MAWoodMain/PowerMonitorMK4/Hat/PDF Schematic/Hat.pdf

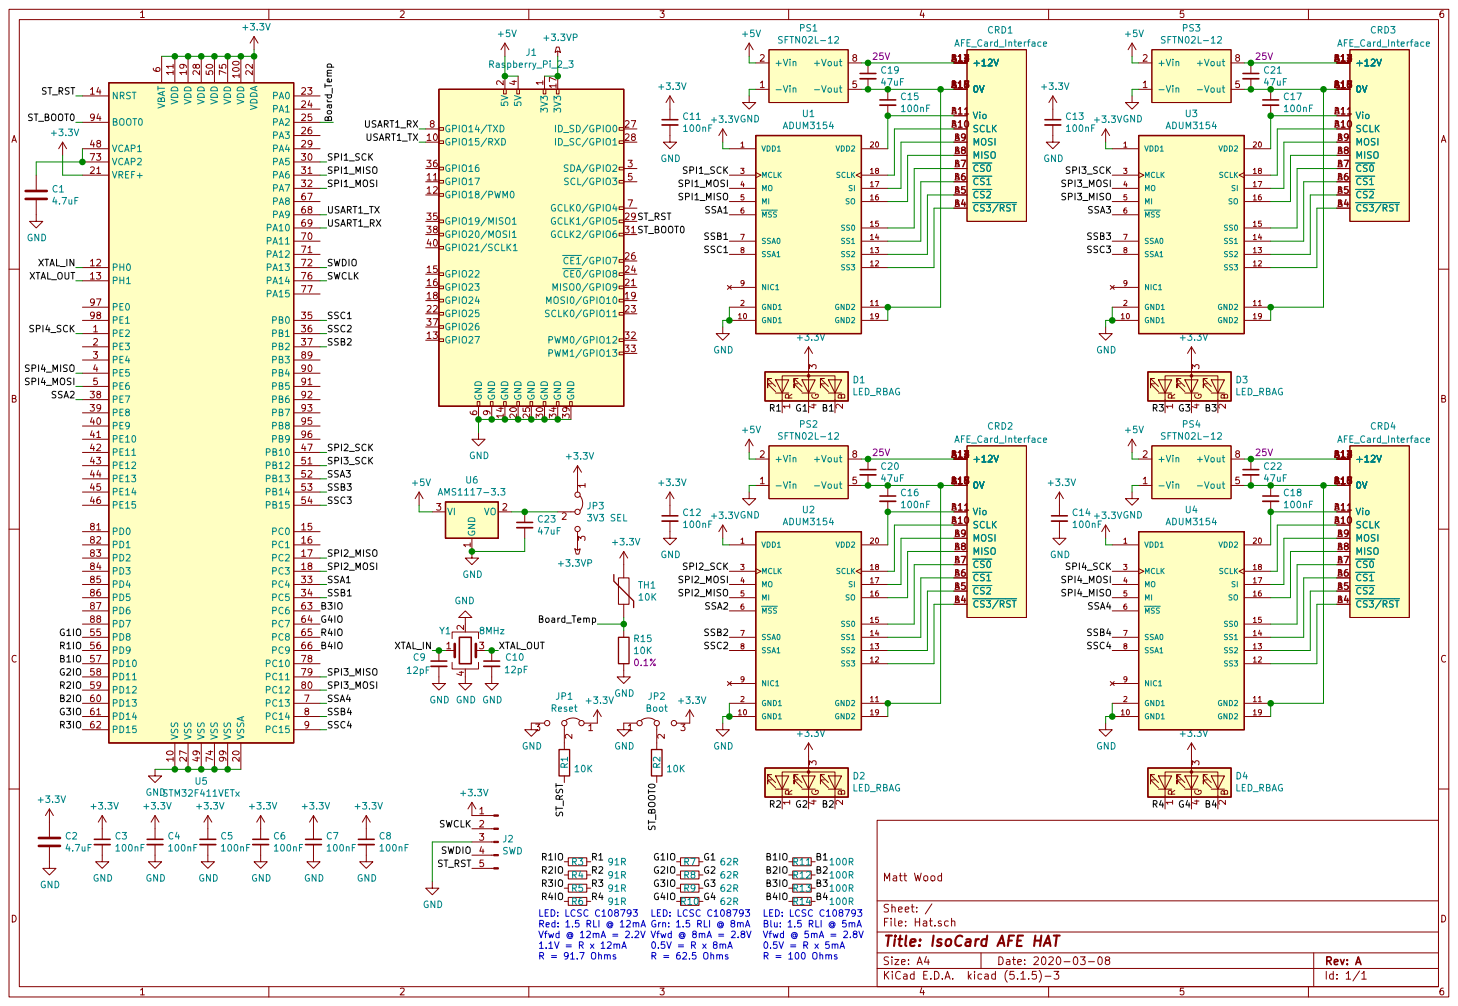
[picture p1: page 1]

6 VCAP1 48 VCAP2 73 VDD 100 VDD 11 VDD 19 VDD 28 VDD 50 VDD 75 VDDA 22 VREF+ 21 VSS 10 VSS 27 VSS 49 VSS 74 VSS 99 VSSA 20 U5 STM32F411VETx

File: Hat.sch Sheet: / Matt Wood

0.5V = R x 8mA R = 62.5 Ohms LED: LCSC C108793 Red: 1.5 RLI @ 12mA

Id: 1/1 Title: IsoCard AFE HAT
