MAWoodMain/PowerMonitorMK4/VC-01 Card/PDF Schematic/VC-01 Card.pdf

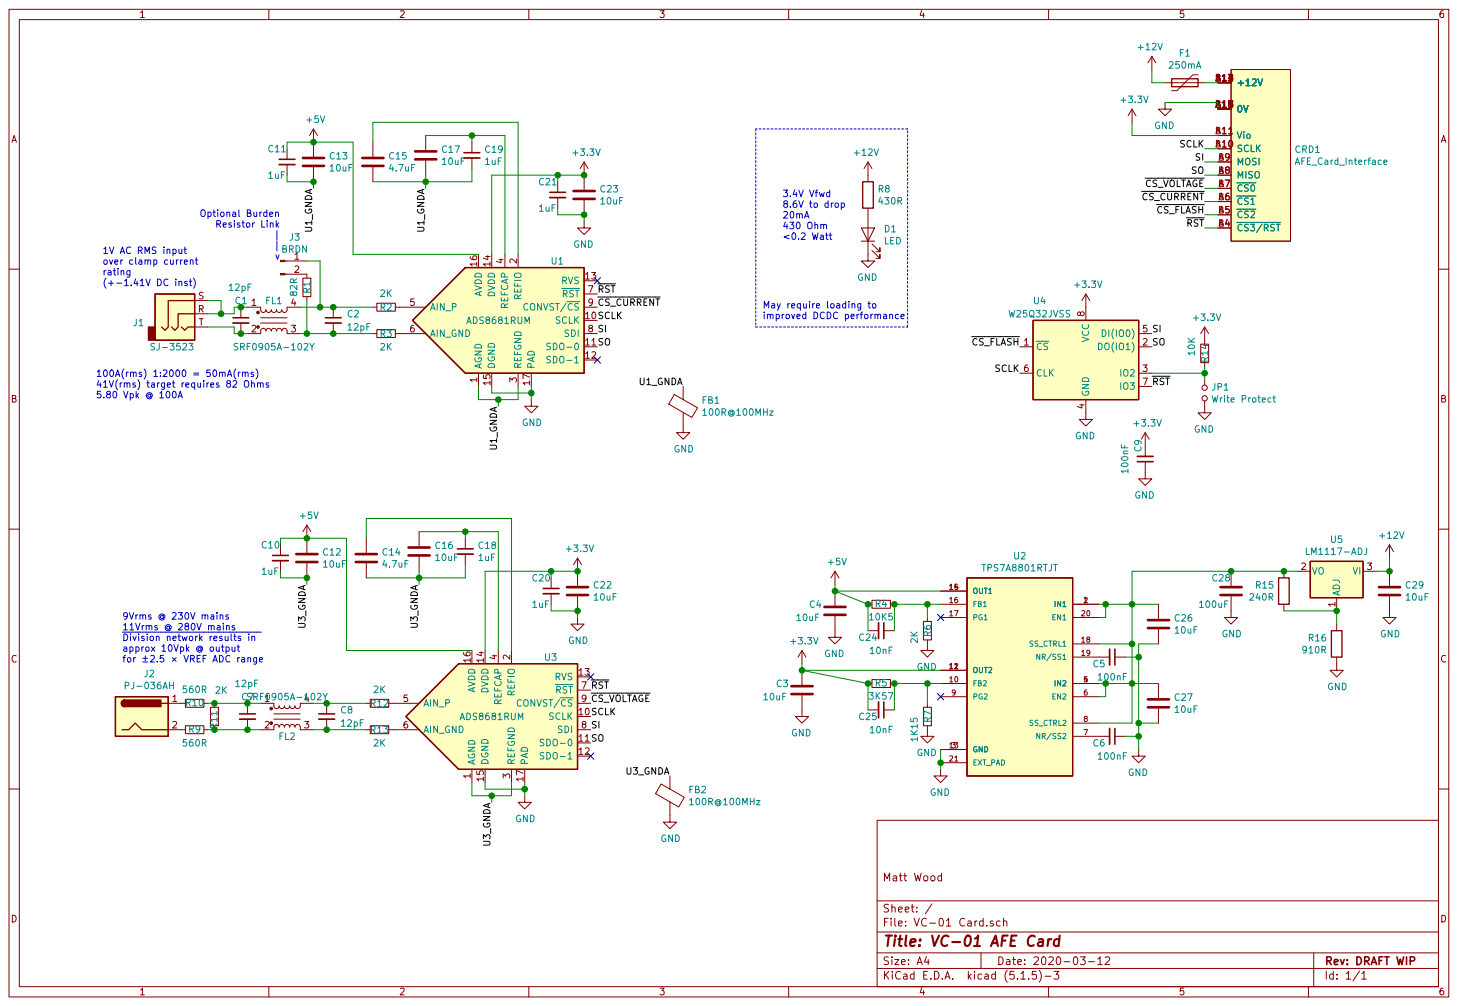
[picture p2: page 1]

Optional Burden Resistor Link

4 AIN_P 5 AIN_GND 6 RST 7 SDI 8 CONVST/CS 9 U1 ADS8681RUM

1 SCLK 10 SDO-0 11 SDO-1 12 RVS 13 DVDD 14 DGND 15 AVDD 16 PAD 17 REFIO

100A(rms) 1:2000 = 50mA(rms)
41V(rms) target requires 82 Ohms
5.80 Vpk @ 100A

9Vrms @ 230V mains 11Vrms @ 280V mains Division network results in approx 10Vpk @ output

4 AIN_P 5 AIN_GND 6 RST 7 SDI 8 CONVST/CS 9 U3 ADS8681RUM

for ±2.5 × VREF ADC range

File: VC-01 Card.sch Sheet: / Matt Wood

Id: 1/1 Title: VC-01 AFE Card
