MAWoodMain/PowerMonitorMK4/Hat/PDF Gerbers/Hat-B_Paste.pdf

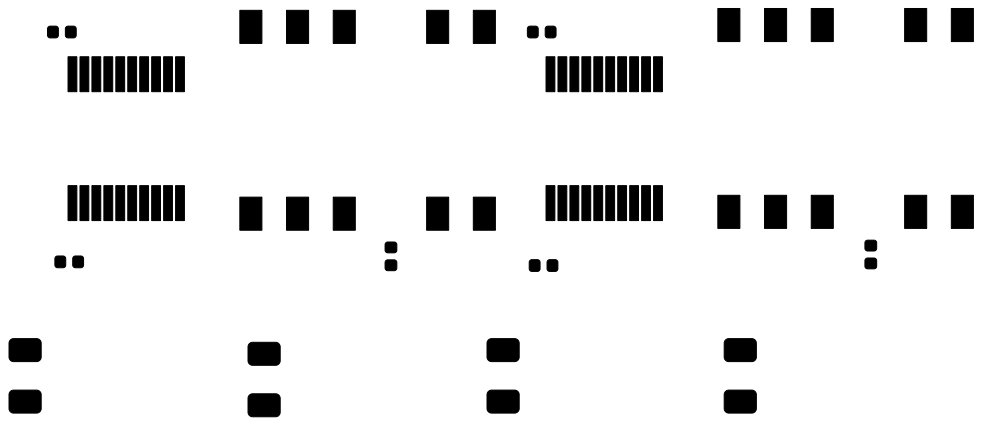
[picture p5: page 1]

File: Hat.kicad_pcb Sheet: Matt Wood

Id: 1/1 Title: IsoCard AFE HAT
