MAWoodMain/PowerMonitorMK4/Hat/PDF Gerbers/Hat-B_SilkS.pdf

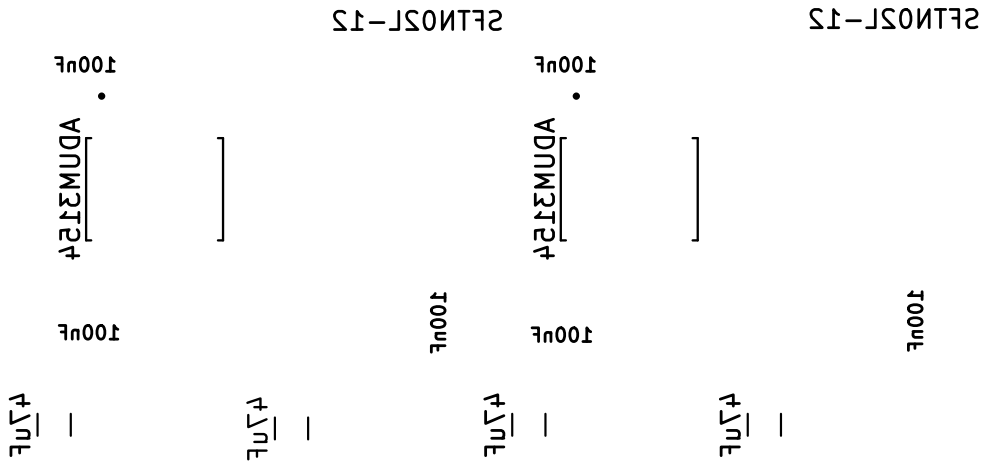
[picture p6: page 1]

File: Hat.kicad_pcb Sheet: Matt Wood

Id: 1/1 Title: IsoCard AFE HAT
