MAWoodMain/PowerMonitorMK4/Hat/PDF Gerbers/Hat-Edge_Cuts.pdf

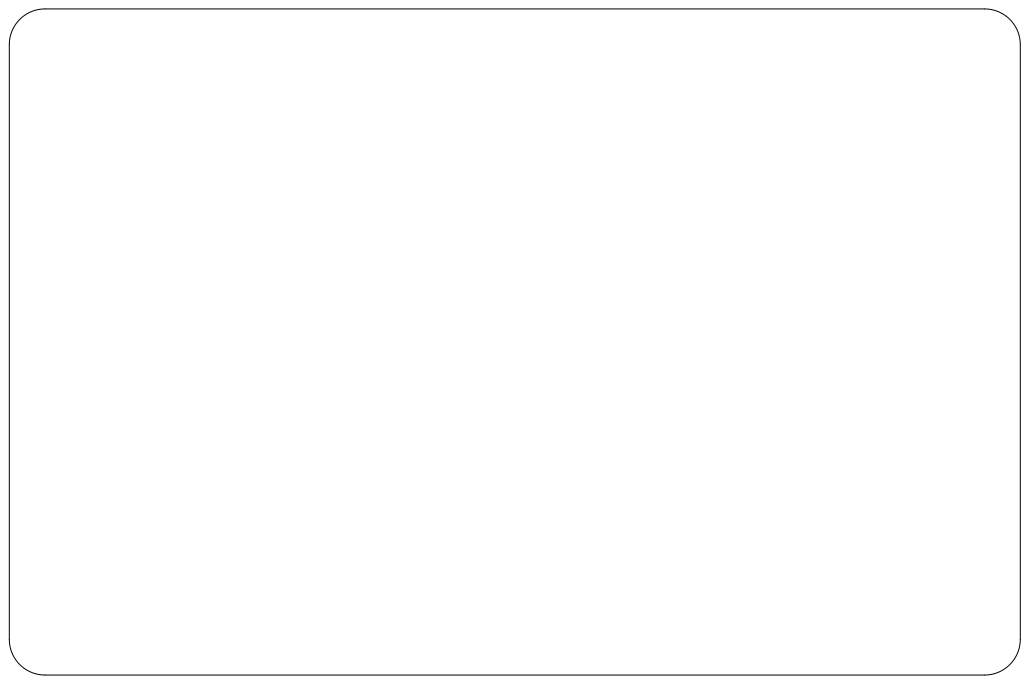
[picture p7: page 1]

File: Hat.kicad_pcb Sheet: Matt Wood

Id: 1/1 Title: IsoCard AFE HAT
