MAWoodMain/PowerMonitorMK4/Hat/PDF Gerbers/Hat-F_Cu.pdf

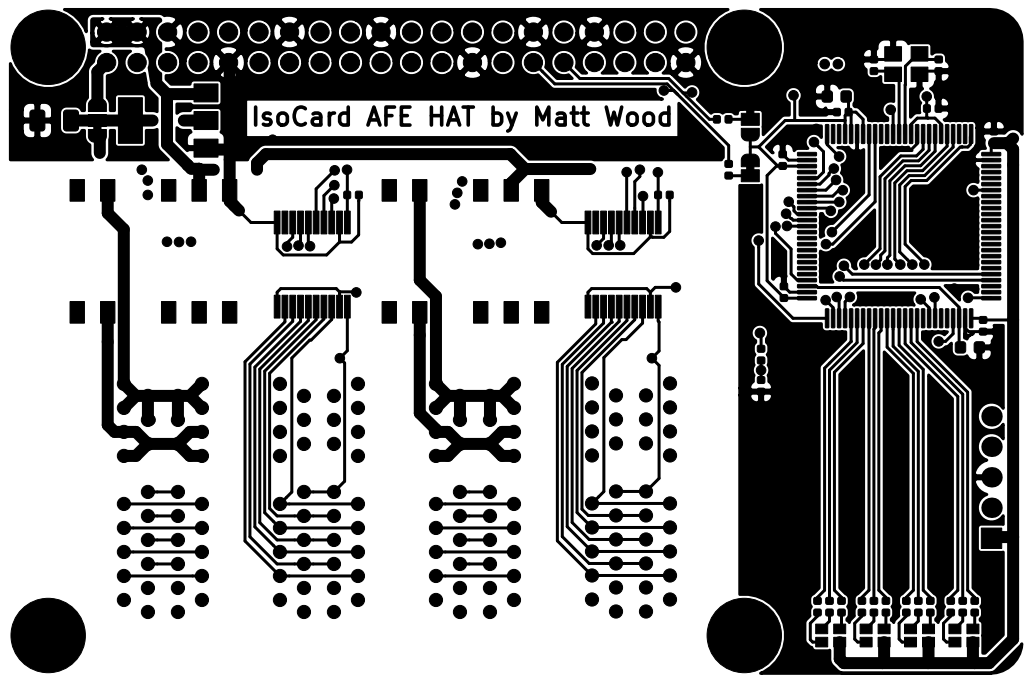
[picture p8: page 1]

IsoCard AFE HAT by Matt Wood

File: Hat.kicad_pcb Sheet: Matt Wood

Id: 1/1 Title: IsoCard AFE HAT
