MAWoodMain/PowerMonitorMK4/Hat/PDF Gerbers/Hat-F_Paste.pdf

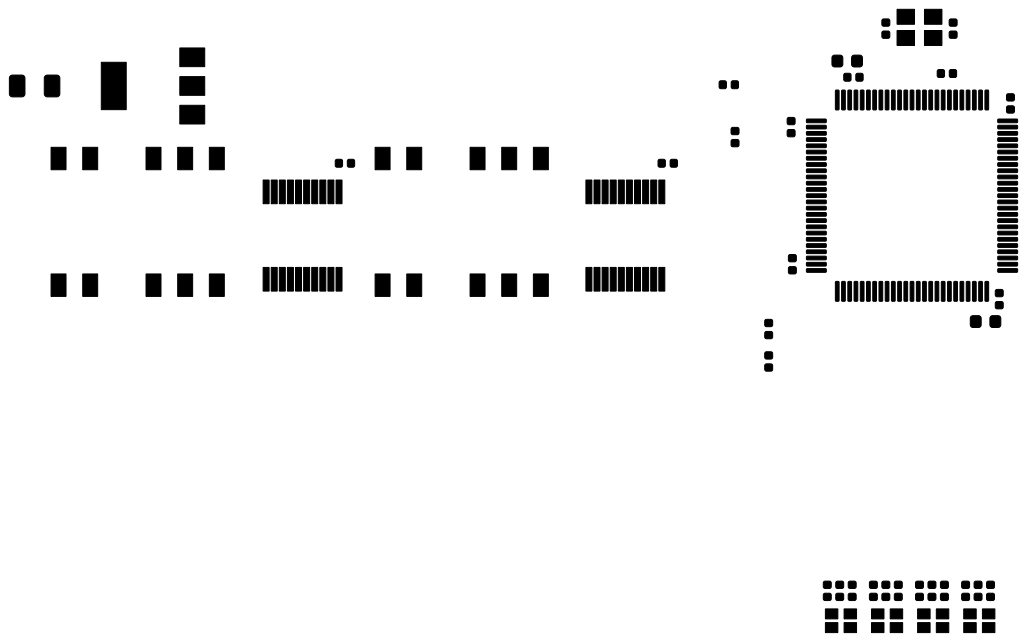
[picture p9: page 1]

File: Hat.kicad_pcb Sheet: Matt Wood

Id: 1/1 Title: IsoCard AFE HAT
