MAWoodMain/PowerMonitorMK4/Hat/PDF Gerbers/Hat-F_SilkS.pdf

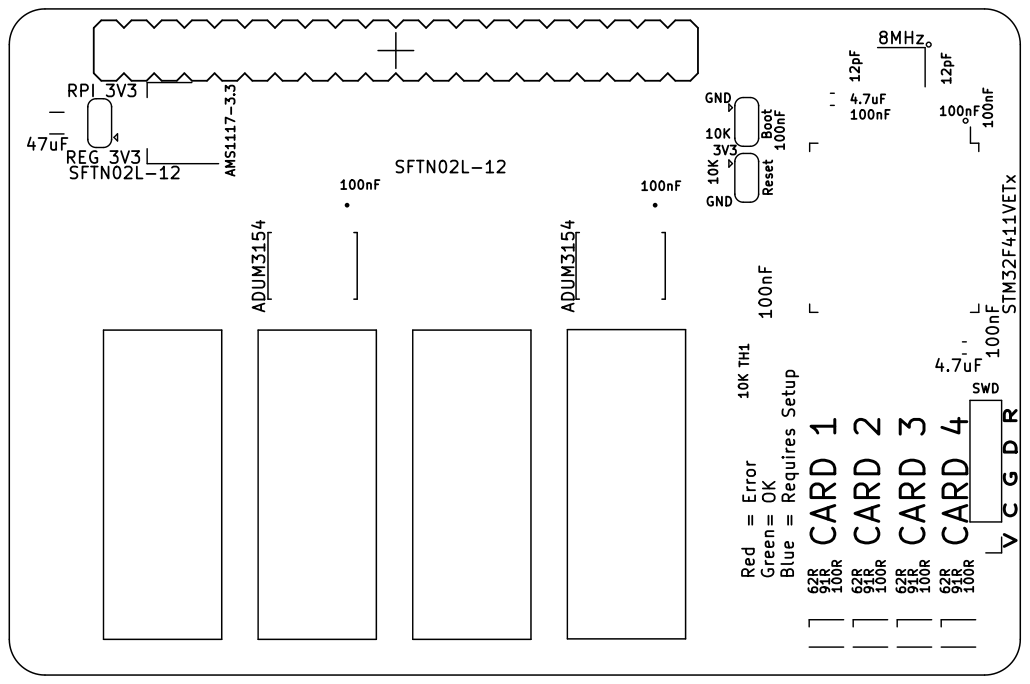
[picture p10: page 1]

3V3 Red Green BlueCARD 1 CARD 2 CARD 3 CARD 4

File: Hat.kicad_pcb Sheet: Matt Wood

Id: 1/1 Title: IsoCard AFE HAT
