MAWoodMain/PowerMonitorMK4/Hat/PDF Gerbers/Hat-In1_Cu.pdf

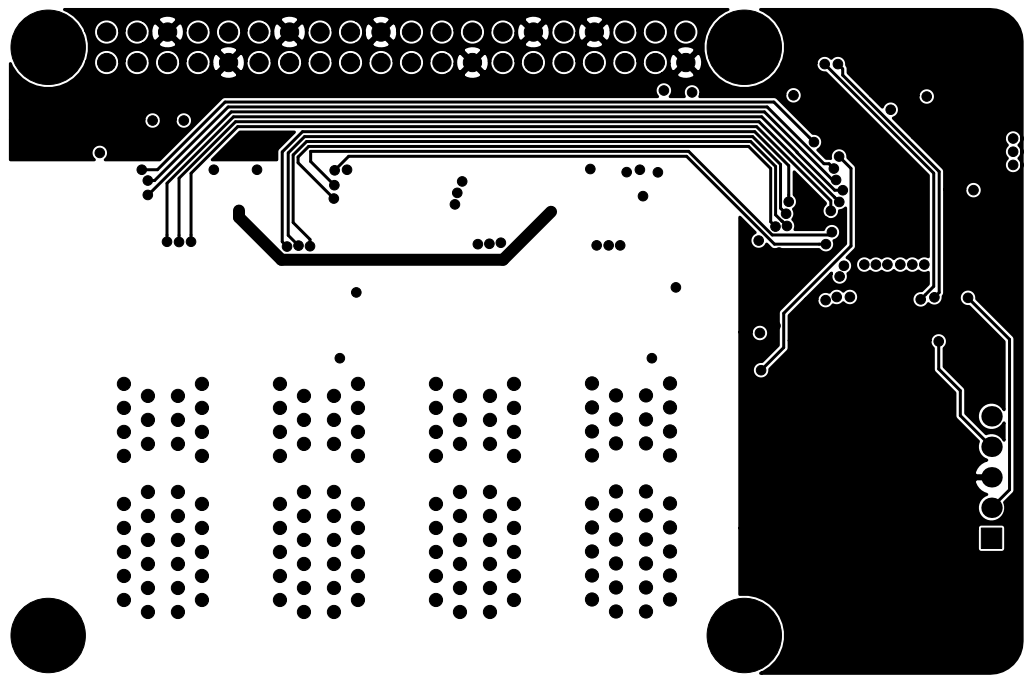
[picture p11: page 1]

File: Hat.kicad_pcb Sheet: Matt Wood

Id: 1/1 Title: IsoCard AFE HAT
