MAWoodMain/PowerMonitorMK4/VC-01 Card/PDF Gerbers/VC-01 Card-B_Mask.pdf

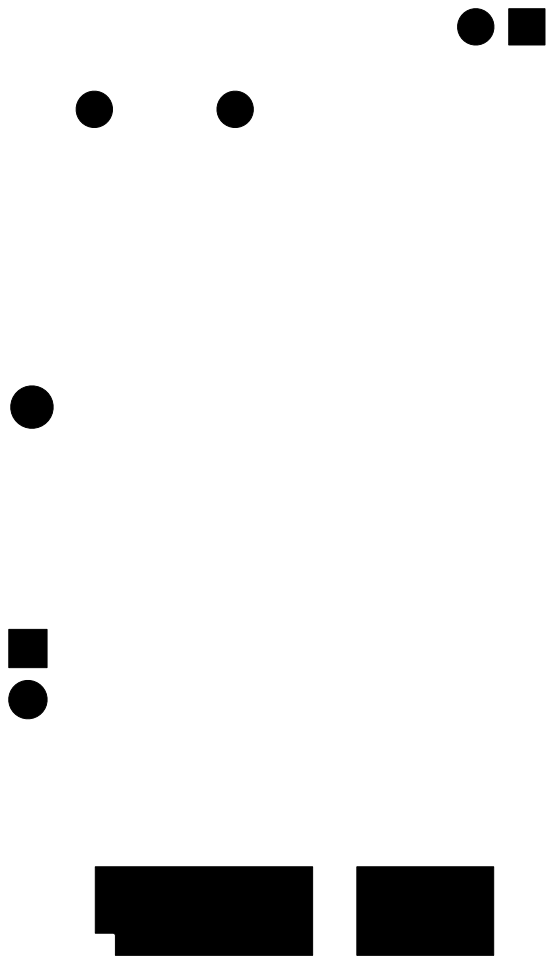
[picture p14: page 1]

File: VC-01 Card.kicad_pcb Sheet: Matt Wood

Id: 1/1 Title: VC-01 AFE Card
