MAWoodMain/PowerMonitorMK4/Hat/Hat.kicad_pcb

## KiCad design Hat/Hat.kicad_pcb (2020-04-18)

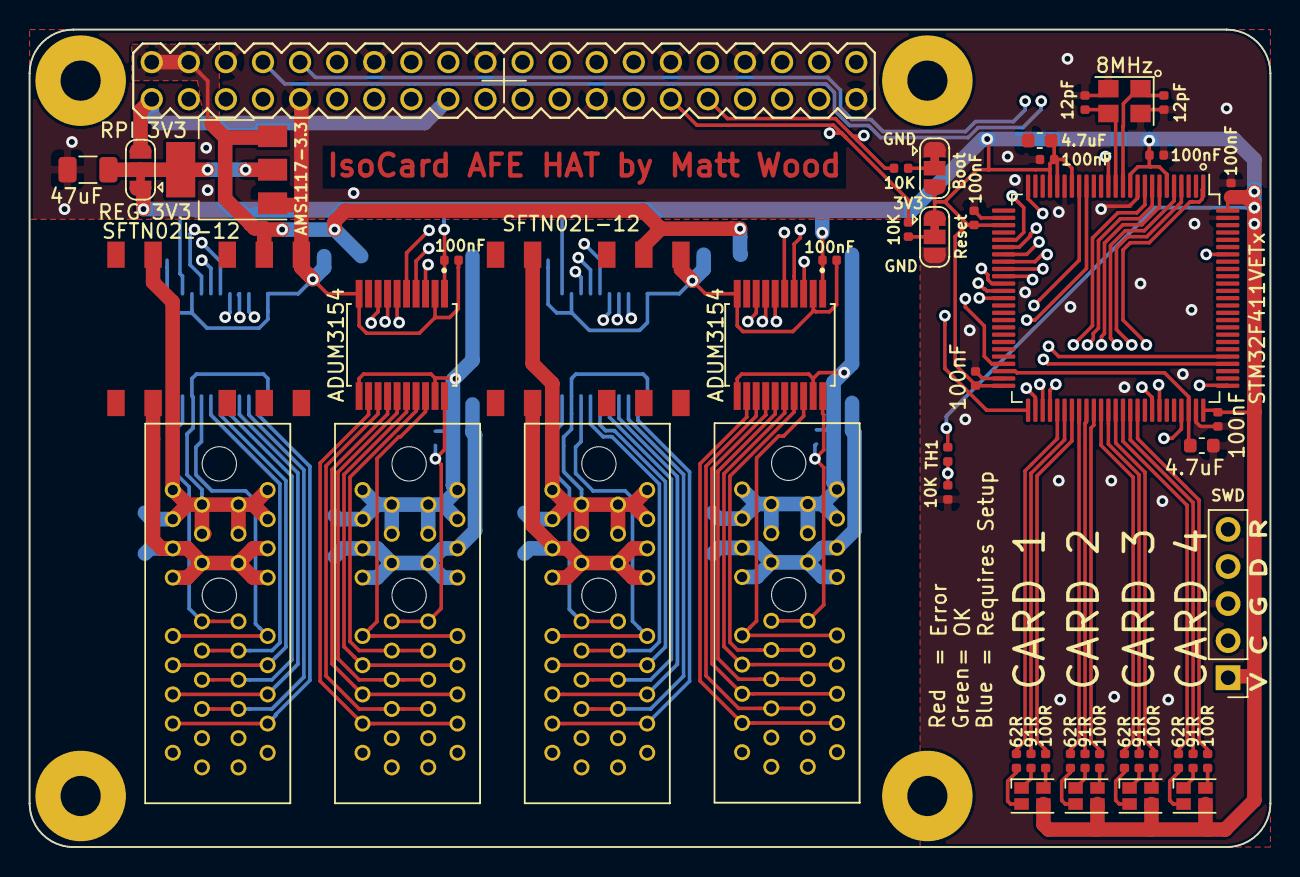
[picture p21: board Hat.kicad_pcb from above]

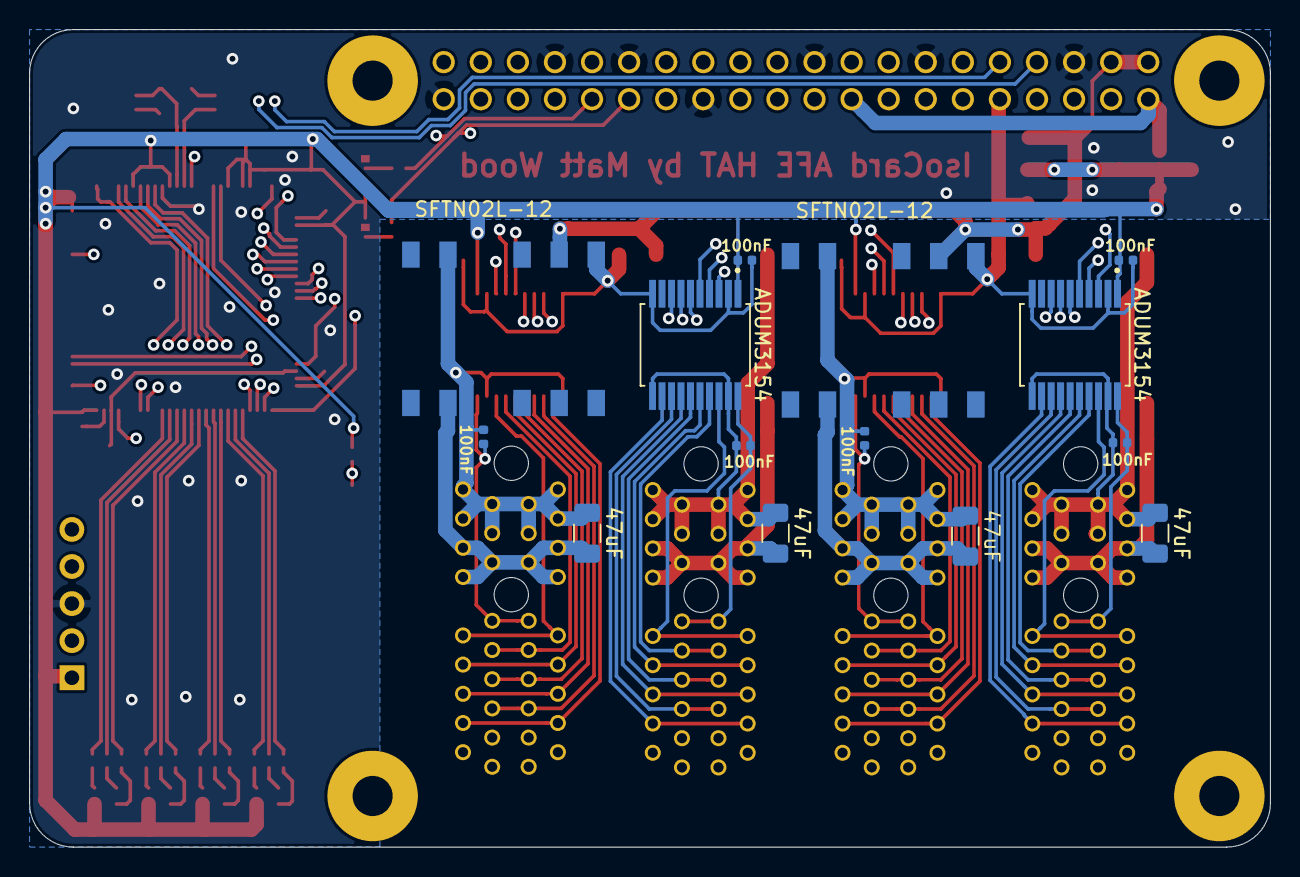
[picture p22: board Hat.kicad_pcb from below]

Board: 4 copper layers, 85.0 x 56.0 mm, 63 parts (14 on the bottom side), 105 nets.

Parts:
C1, C2: 4.7uF; C_0603_1608Metric
C3, C4, C5, C6, C7, C8, C11, C12, C13, C14, C15, C16, C17, C18: 100nF; C_0402_1005Metric
C9, C10: 12pF; C_0402_1005Metric
C19, C20, C21, C22, C23: 47uF; C_1206_3216Metric
CRD1, CRD2, CRD3, CRD4: AFE_Card_Interface; PCIE-036-02-X-D-TH
D1, D2, D3, D4: LED_RBAG; LED_Cree-PLCC4_2x2mm_CW
J1: Raspberry_Pi_2_3; RASPBERRY_PI_B+
J2: SWD; PinHeader_1x05_P2.54mm_Vertical
JP1: Reset; SolderJumper-3_P1.3mm_Bridged12_RoundedPad1.0x1.5mm
JP2: Boot; SolderJumper-3_P1.3mm_Bridged12_RoundedPad1.0x1.5mm
JP3: 3V3 SEL; SolderJumper-3_P1.3mm_Bridged12_RoundedPad1.0x1.5mm
PS1, PS2, PS3, PS4: SFTN02L-12; SFTN02
R1, R2: 10K; R_0402_SILK_VAL
R3, R4, R5, R6: 91R; R_0402_SILK_VAL
R7, R8, R9, R10: 62R; R_0402_SILK_VAL
R11, R12, R13, R14: 100R; R_0402_SILK_VAL
R15: 10K; R_0402_1005Metric
TH1: 10K; R_0402_1005Metric
U1, U2, U3, U4: ADUM3154; SOP65P780X200-20N
U5: STM32F411VETx; LQFP-100_14x14mm_P0.5mm
U6: AMS1117-3.3; SOT-223-3_TabPin2
Y1: 8MHz; Crystal_SMD_3225-4Pin_3.2x2.5mm

Connections:
+3.3VP: J1.1, J1.17, JP3.3
+3V3: C2.1, C3.1, C4.1, C5.1, C6.1, C7.1, C8.1, C11.1, C12.1, C13.1, C14.1, D1.3, D2.3, D3.3, D4.3, J2.1, JP1.1, JP2.3, JP3.1, TH1.1, U1.1, U2.1, U3.1, U4.1, U5.6, U5.11, U5.19, U5.21, U5.22, U5.28, U5.50, U5.75, U5.100
+5V: J1.2, J1.4, PS1.2, PS2.2, PS3.2, PS4.2, U6.3
/B1: D1.2, R11.1
/B1IO: R11.2, U5.57
/B2: D2.2, R12.1
/B2IO: R12.2, U5.60
/B3: D3.2, R13.1
/B3IO: R13.2, U5.63
/B4: D4.2, R14.1
/B4IO: R14.2, U5.66
/Board_Temp: R15.1, TH1.2, U5.25
/G1: D1.4, R7.1
/G1IO: R7.2, U5.55
/G2: D2.4, R8.1
/G2IO: R8.2, U5.58
/G3: D3.4, R9.1
/G3IO: R9.2, U5.61
/G4: D4.4, R10.1
/G4IO: R10.2, U5.64
/R1: D1.1, R3.1
/R1IO: R3.2, U5.56
/R2: D2.1, R4.1
/R2IO: R4.2, U5.59
/R3: D3.1, R5.1
/R3IO: R5.2, U5.62
/R4: D4.1, R6.1
/R4IO: R6.2, U5.65
/SPI1_MISO: U1.5, U5.31
/SPI1_MOSI: U1.4, U5.32
/SPI1_SCK: U1.3, U5.30
/SPI2_MISO: U2.5, U5.17
/SPI2_MOSI: U2.4, U5.18
/SPI2_SCK: U2.3, U5.47
/SPI3_MISO: U3.5, U5.79
/SPI3_MOSI: U3.4, U5.80
/SPI3_SCK: U3.3, U5.51
/SPI4_MISO: U4.5, U5.4
/SPI4_MOSI: U4.4, U5.5
/SPI4_SCK: U4.3, U5.1
/SSA1: U1.6, U5.33
/SSA2: U2.6, U5.38
/SSA3: U3.6, U5.52
/SSA4: U4.6, U5.7
/SSB1: U1.7, U5.34
/SSB2: U2.7, U5.37
/SSB3: U3.7, U5.53
/SSB4: U4.7, U5.8
/SSC1: U1.8, U5.35
/SSC2: U2.8, U5.36
/SSC3: U3.8, U5.54
/SSC4: U4.8, U5.9
/ST_BOOT0: J1.31, R2.2, U5.94
/ST_RST: J1.29, J2.5, R1.2, U5.14
/SWCLK: J2.2, U5.76
/SWDIO: J2.4, U5.72
/USART1_RX: J1.8, U5.69
/USART1_TX: J1.10, U5.68
/XTAL_IN: C9.1, U5.12, Y1.1
/XTAL_OUT: C10.1, U5.13, Y1.3
GND: C1.2, C2.2, C3.2, C4.2, C5.2, C6.2, C7.2, C8.2, C9.2, C10.2, C11.2, C12.2, C13.2, C14.2, C23.2, J1.6, J1.9, J1.14, J1.20, J1.25, J1.30, J1.34, J1.39, J2.3, JP1.3, JP2.1, PS1.1, PS2.1, PS3.1, PS4.1, R15.2, U1.2, U1.10, U2.2, U2.10, U3.2, U3.10, U4.2, U4.10, U5.10, U5.20, U5.27, U5.49, U5.74, U5.99, U6.1, Y1.2, Y1.4
unnamed: C1.1, U5.48, U5.73
unnamed: C15.1, C19.2, CRD1.A15, CRD1.A16, CRD1.A17, CRD1.A18, CRD1.B15, CRD1.B16, CRD1.B17, CRD1.B18, PS1.5, U1.11, U1.19
unnamed: C15.2, CRD1.A11, CRD1.B11, U1.20
unnamed: C16.1, C20.2, CRD2.A15, CRD2.A16, CRD2.A17, CRD2.A18, CRD2.B15, CRD2.B16, CRD2.B17, CRD2.B18, PS2.5, U2.11, U2.19
unnamed: C16.2, CRD2.A11, CRD2.B11, U2.20
unnamed: C17.1, C21.2, CRD3.A15, CRD3.A16, CRD3.A17, CRD3.A18, CRD3.B15, CRD3.B16, CRD3.B17, CRD3.B18, PS3.5, U3.11, U3.19
unnamed: C17.2, CRD3.A11, CRD3.B11, U3.20
unnamed: C18.1, C22.2, CRD4.A15, CRD4.A16, CRD4.A17, CRD4.A18, CRD4.B15, CRD4.B16, CRD4.B17, CRD4.B18, PS4.5, U4.11, U4.19
unnamed: C18.2, CRD4.A11, CRD4.B11, U4.20
unnamed: C19.1, CRD1.A12, CRD1.A13, CRD1.A14, CRD1.B12, CRD1.B13, CRD1.B14, PS1.8
unnamed: C20.1, CRD2.A12, CRD2.A13, CRD2.A14, CRD2.B12, CRD2.B13, CRD2.B14, PS2.8
unnamed: C21.1, CRD3.A12, CRD3.A13, CRD3.A14, CRD3.B12, CRD3.B13, CRD3.B14, PS3.8
unnamed: C22.1, CRD4.A12, CRD4.A13, CRD4.A14, CRD4.B12, CRD4.B13, CRD4.B14, PS4.8
unnamed: C23.1, JP3.2, U6.2
unnamed: CRD1.A4, CRD1.B4, U1.12
unnamed: CRD1.A5, CRD1.B5, U1.13
unnamed: CRD1.A6, CRD1.B6, U1.14
unnamed: CRD1.A7, CRD1.B7, U1.15
unnamed: CRD1.A8, CRD1.B8, U1.16
unnamed: CRD1.A9, CRD1.B9, U1.17
unnamed: CRD1.A10, CRD1.B10, U1.18
unnamed: CRD2.A4, CRD2.B4, U2.12
unnamed: CRD2.A5, CRD2.B5, U2.13
unnamed: CRD2.A6, CRD2.B6, U2.14
unnamed: CRD2.A7, CRD2.B7, U2.15
unnamed: CRD2.A8, CRD2.B8, U2.16
unnamed: CRD2.A9, CRD2.B9, U2.17
unnamed: CRD2.A10, CRD2.B10, U2.18
unnamed: CRD3.A4, CRD3.B4, U3.12
unnamed: CRD3.A5, CRD3.B5, U3.13
unnamed: CRD3.A6, CRD3.B6, U3.14
unnamed: CRD3.A7, CRD3.B7, U3.15
unnamed: CRD3.A8, CRD3.B8, U3.16
unnamed: CRD3.A9, CRD3.B9, U3.17
unnamed: CRD3.A10, CRD3.B10, U3.18
unnamed: CRD4.A4, CRD4.B4, U4.12
unnamed: CRD4.A5, CRD4.B5, U4.13
unnamed: CRD4.A6, CRD4.B6, U4.14
unnamed: CRD4.A7, CRD4.B7, U4.15
unnamed: CRD4.A8, CRD4.B8, U4.16
unnamed: CRD4.A9, CRD4.B9, U4.17
unnamed: CRD4.A10, CRD4.B10, U4.18
unnamed: JP1.2, R1.1
unnamed: JP2.2, R2.1
