MAWoodMain/PowerMonitorMK4/VC-01 Card/VC-01 Card.kicad_pcb

## KiCad design VC-01 Card/VC-01 Card.kicad_pcb (2020-03-14)

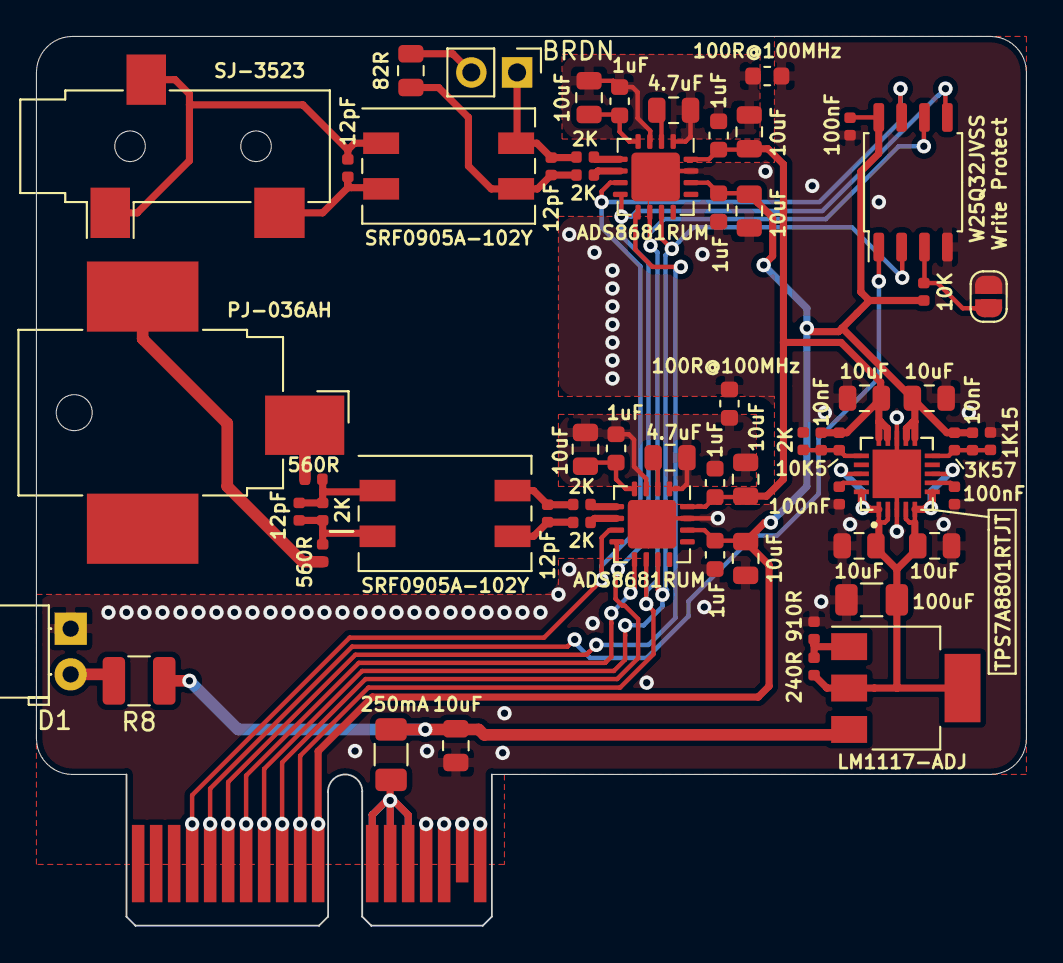
[picture p23: board VC-01 Card.kicad_pcb from above]

Board: 2 copper layers, 55.0 x 49.4 mm, 61 parts (0 on the bottom side), 41 nets.

Parts:
C1, C2, C7, C8: 12pF; C_0402_1005Metric
C3, C4, C12, C13, C16, C17, C22, C23, C26, C27, C29: 10uF; C_0805_2012Metric
C5, C6, C9: 100nF; C_0402_1005Metric
C10, C11, C18, C19, C20, C21: 1uF; C_0603_1608Metric
C14, C15: 4.7uF; C_0805_2012Metric
C24, C25: 10nF; C_0402_1005Metric
C28: 100uF; C_1206_3216Metric
CRD1: AFE_Card_Interface; BUS_PCIexpress_x1
D1: LED; LED_D5.0mm_Horizontal_O1.27mm_Z3.0mm
F1: 250mA; Fuse_1206_3216Metric
FB1, FB2: 100R@100MHz; R_0603_1608Metric
FL1, FL2: SRF0905A-102Y; Filter_Bourns_SRF0905_6.0x9.2mm
J1: SJ-3523; Jack_3.5mm_CUI_SJ-3523-SMT_Horizontal
J2: PJ-036AH; BarrelJack_CUI_PJ-036AH-SMT_Horizontal
J3: BRDN; PinHeader_1x02_P2.54mm_Vertical
JP1: Write Protect; SolderJumper-2_P1.3mm_Open_RoundedPad1.0x1.5mm
R1: 82R; R_0805_2012Metric
R2, R3, R6, R11, R12, R13: 2K; R_0402_1005Metric
R4: 10K5; R_0402_1005Metric
R5: 3K57; R_0402_1005Metric
R7: 1K15; R_0402_1005Metric
R8: R; R_1210_3225Metric
R9, R10: 560R; R_0402_1005Metric
R14: 10K; R_0402_1005Metric
R15: 240R; R_0402_1005Metric
R16: 910R; R_0402_1005Metric
U1, U3: ADS8681RUM; QFN-16-1EP_4x4mm_P0.65mm_EP2.7x2.7mm
U2: TPS7A8801RTJT; QFN50P400X400X80-21N
U4: W25Q32JVSS; SOIC-8_5.23x5.23mm_P1.27mm
U5: LM1117-ADJ; SOT-223-3_TabPin2

Connections:
+3V3: C3.1, C9.2, C20.1, C21.1, C22.1, C23.1, C25.2, CRD1.A11, CRD1.B11, R5.1, R14.1, U1.14, U2.11, U2.12, U3.14, U4.8
+5V: C4.1, C10.1, C11.1, C12.1, C13.1, C24.2, R4.1, U1.16, U2.14, U2.15, U3.16
+12V: C29.1, F1.2, R8.1, U5.3
/SCLK: CRD1.A10, CRD1.B10, U1.10, U3.10, U4.6
/SI: CRD1.A9, CRD1.B9, U1.8, U3.8, U4.5
/SO: CRD1.A8, CRD1.B8, U1.11, U3.11, U4.2
/U1_GNDA: C11.2, C13.2, C15.2, C17.2, C19.2, FB1.1, U1.1, U1.3
/U3_GNDA: C10.2, C12.2, C14.2, C16.2, C18.2, FB2.1, U3.1, U3.3
/~CS_CURRENT: CRD1.A6, CRD1.B6, U1.9
/~CS_FLASH: CRD1.A5, CRD1.B5, U4.1
/~CS_VOLTAGE: CRD1.A7, CRD1.B7, U3.9
/~RST: CRD1.A4, CRD1.B4, U1.7, U3.7, U4.7
GND: C3.2, C4.2, C5.1, C6.1, C9.1, C20.2, C21.2, C22.2, C23.2, C26.2, C27.2, C28.2, C29.2, CRD1.A15, CRD1.A16, CRD1.A17, CRD1.A18, CRD1.B15, CRD1.B16, CRD1.B17, CRD1.B18, D1.1, FB1.2, FB2.2, JP1.2, R6.2, R7.2, R16.2, U1.15, U1.17, U2.3, U2.13, U2.21, U3.15, U3.17, U4.4
unnamed: C1.1, FL1.1, J1.R, J1.S
unnamed: C1.2, FL1.2, J1.T
unnamed: C2.1, FL1.4, J3.1, R2.2
unnamed: C2.2, FL1.3, R1.2, R3.2
unnamed: C5.2, U2.19
unnamed: C6.2, U2.7
unnamed: C7.1, FL2.1, R10.1, R11.1
unnamed: C7.2, FL2.2, R9.1, R11.2
unnamed: C8.1, FL2.4, R12.2
unnamed: C8.2, FL2.3, R13.2
unnamed: C14.1, U3.2
unnamed: C15.1, U1.2
unnamed: C16.1, C18.1, U3.4
unnamed: C17.1, C19.1, U1.4
unnamed: C24.1, R4.2, R6.1, U2.16
unnamed: C25.1, R5.2, R7.1, U2.10
unnamed: C26.1, C27.1, C28.1, R15.1, U2.1, U2.2, U2.4, U2.5, U2.6, U2.8, U2.18, U2.20, U5.2
unnamed: CRD1.A12, CRD1.A13, CRD1.A14, CRD1.B12, CRD1.B13, CRD1.B14, F1.1
unnamed: D1.2, R8.2
unnamed: J2.1, R10.2
unnamed: J2.2, R9.2
unnamed: J3.2, R1.1
unnamed: JP1.1, R14.2, U4.3
unnamed: R2.1, U1.5
unnamed: R3.1, U1.6
unnamed: R12.1, U3.5
unnamed: R13.1, U3.6
unnamed: R15.2, R16.1, U5.1
