MAWoodMain/PowerMonitorMK4/CubeMX/CubeMX.ioc

Mcu.UserName=STM32F411VETx
PA1.GPIO_Label=Board_Temp
PA1.Signal=ADCx_IN1
PA10.Signal=USART1_RX
PA5.Signal=SPI1_SCK
PA6.Signal=SPI1_MISO
PA7.Signal=SPI1_MOSI
PA9.Signal=USART1_TX
PB0.GPIO_Label=SSC1
PB0.Signal=GPIO_Output
PB1.GPIO_Label=SSC2
PB1.Signal=GPIO_Output
PB10.Signal=SPI2_SCK
PB12.Signal=SPI3_SCK
PB13.GPIO_Label=SSA3
PB13.Signal=GPIO_Output
PB14.GPIO_Label=SSB3
PB14.Signal=GPIO_Output
PB15.GPIO_Label=SSC3
PB15.Signal=GPIO_Output
PB2.GPIO_Label=SSB2
PB2.Signal=GPIO_Output
PC11.Signal=SPI3_MISO
PC12.Signal=SPI3_MOSI
PC13-ANTI_TAMP.GPIO_Label=SSA4
PC13-ANTI_TAMP.Signal=GPIO_Output
PC14-OSC32_IN.GPIO_Label=SSB4
PC14-OSC32_IN.Signal=GPIO_Output
PC15-OSC32_OUT.GPIO_Label=SSC4
PC15-OSC32_OUT.Signal=GPIO_Output
PC2.Signal=SPI2_MISO
PC3.Signal=SPI2_MOSI
PC4.GPIO_Label=SSA1
PC4.Signal=GPIO_Output
PC5.GPIO_Label=SSB1
PC5.Signal=GPIO_Output
PC6.GPIO_Label=B3
PC6.Signal=GPIO_Output
PC7.GPIO_Label=G4
PC7.Signal=GPIO_Output
PC8.GPIO_Label=R4
PC8.Signal=GPIO_Output
PC9.GPIO_Label=B4
PC9.Signal=GPIO_Output
PD10.GPIO_Label=B1
PD10.Signal=GPIO_Output
PD11.GPIO_Label=G2
PD11.Signal=GPIO_Output
PD12.GPIO_Label=R2
PD12.Signal=GPIO_Output
PD13.GPIO_Label=B2
PD13.Signal=GPIO_Output
PD14.GPIO_Label=G3
PD14.Signal=GPIO_Output
PD15.GPIO_Label=R3
PD15.Signal=GPIO_Output
PD8.GPIO_Label=G1
PD8.Signal=GPIO_Output
PD9.GPIO_Label=R1
PD9.Signal=GPIO_Output
PE2.Signal=SPI4_SCK
PE5.Signal=SPI4_MISO
PE6.Signal=SPI4_MOSI
PE7.GPIO_Label=SSA2
PE7.Signal=GPIO_Output
