MAWoodMain/PowerMonitorMK4/Firmware/Core/Inc/main.h

#define SSA4_Pin GPIO_PIN_13
#define SSA4_GPIO_Port GPIOC
#define SSB4_Pin GPIO_PIN_14
#define SSB4_GPIO_Port GPIOC
#define SSC4_Pin GPIO_PIN_15
#define SSC4_GPIO_Port GPIOC
#define Board_Temp_Pin GPIO_PIN_1
#define Board_Temp_GPIO_Port GPIOA
#define SSA1_Pin GPIO_PIN_4
#define SSA1_GPIO_Port GPIOC
#define SSB1_Pin GPIO_PIN_5
#define SSB1_GPIO_Port GPIOC
#define SSC1_Pin GPIO_PIN_0
#define SSC1_GPIO_Port GPIOB
#define SSC2_Pin GPIO_PIN_1
#define SSC2_GPIO_Port GPIOB
#define SSB2_Pin GPIO_PIN_2
#define SSB2_GPIO_Port GPIOB
#define SSA2_Pin GPIO_PIN_7
#define SSA2_GPIO_Port GPIOE
#define SSA3_Pin GPIO_PIN_13
#define SSA3_GPIO_Port GPIOB
#define SSB3_Pin GPIO_PIN_14
#define SSB3_GPIO_Port GPIOB
#define SSC3_Pin GPIO_PIN_15
#define SSC3_GPIO_Port GPIOB
#define G1_Pin GPIO_PIN_8
#define G1_GPIO_Port GPIOD
#define R1_Pin GPIO_PIN_9
#define R1_GPIO_Port GPIOD
#define B1_Pin GPIO_PIN_10
#define B1_GPIO_Port GPIOD
#define G2_Pin GPIO_PIN_11
#define G2_GPIO_Port GPIOD
#define R2_Pin GPIO_PIN_12
#define R2_GPIO_Port GPIOD
#define B2_Pin GPIO_PIN_13
#define B2_GPIO_Port GPIOD
#define G3_Pin GPIO_PIN_14
#define G3_GPIO_Port GPIOD
#define R3_Pin GPIO_PIN_15
#define R3_GPIO_Port GPIOD
#define B3_Pin GPIO_PIN_6
#define B3_GPIO_Port GPIOC
#define G4_Pin GPIO_PIN_7
#define G4_GPIO_Port GPIOC
#define R4_Pin GPIO_PIN_8
#define R4_GPIO_Port GPIOC
#define B4_Pin GPIO_PIN_9
#define B4_GPIO_Port GPIOC
