MAWoodMain/PowerMonitorMK4/Firmware/App/Management/inc/management.h

/**
  * @file    management.h 
  * @brief    
  * @version 1.00   
  * @date    18/04/2020
  */

#ifndef MANAGEMENT_H
#define MANAGEMENT_H

/**************************** LIB INCLUDES ******************************/
/**************************** USER INCLUDES *****************************/
/******************************* DEFINES ********************************/
/******************************** ENUMS *********************************/
/****************************** TYPEDEFS ********************************/
/***************************** STRUCTURES *******************************/
/************************** FUNCTION PROTOTYPES *************************/
/******************************* GLOBALS ********************************/
/*        Globals are to be avoided unless justified and documented */
/************************************************************************/

#endif //MANAGEMENT_H
