MAWoodMain/PowerMonitorMK4/Firmware/App/Cards/src/card_vc01.c

/**
  * @file    card_vc01.c 
  * @brief    
  * @version 1.00   
  * @date    10/04/2020
  */

/**************************** LIB INCLUDES ******************************/
/**************************** USER INCLUDES *****************************/
#include "card_vc01.h"
/******************************* DEFINES ********************************/
/******************************** ENUMS *********************************/
/***************************** STRUCTURES *******************************/
/************************** FUNCTION PROTOTYPES *************************/
/******************************* CONSTANTS ******************************/
/******************************* VARIABLES ******************************/
/*************************** PUBLIC FUNCTIONS ***************************/
/*************************** PRIVATE FUNCTIONS **************************/ 
