MAWoodMain/PowerMonitorMK4/Firmware/Core/Inc/card1.h

/**
  * @file    card1.h 
  * @brief    
  * @version 1.00   
  * @date    04/04/2020
  */

#ifndef CARD1_H
#define CARD1_H

/**************************** LIB INCLUDES ******************************/
#include <stdbool.h>
/**************************** USER INCLUDES *****************************/
/******************************* DEFINES ********************************/
/******************************** ENUMS *********************************/
/****************************** TYPEDEFS ********************************/
/***************************** STRUCTURES *******************************/
/************************** FUNCTION PROTOTYPES *************************/
bool card1_init(void);
uint16_t card1_readRaw(uint8_t channelId);
/******************************* GLOBALS ********************************/
/*        Globals are to be avoided unless justified and documented */
/************************************************************************/

#endif //CARD1_H
