MAWoodMain/PowerMonitorMK4/(commit log)

2020-03-08 Completed PI Hat schematic and layout
    [Hat-B_Cu.gbr, Hat-B_Mask.gbr, Hat-B_Paste.gbr, Hat-B_SilkS.gbr, Hat-Edge_Cuts.gbr, Hat-F_Cu.gbr, Hat-F_Mask.gbr, Hat-F_Paste.gbr]
2020-03-08 Unmasked copper text
    [Hat-B_Cu.gbr, Hat-B_Mask.gbr, Hat-B_Paste.gbr, Hat-B_SilkS.gbr, Hat-Edge_Cuts.gbr, Hat-F_Cu.gbr, Hat-F_Mask.gbr, Hat-F_Paste.gbr]
2020-03-09 Added suppliers & costed BOM
    [Hat.csv, Hat.ods, Hat.sch]
2020-03-12 Initial schematic and provisional layout for voltage and current card added and added lib cache to gitignore
    [VC-01 Card.kicad_pcb, VC-01 Card.sch]
2020-03-12 Added VC-01 sheet title and exported schematic, gerbers and pdfs
    [VC-01 Card-B_Cu.gbr, VC-01 Card-B_Mask.gbr, VC-01 Card-B_Paste.gbr, VC-01 Card-B_SilkS.gbr, VC-01 Card-Edge_Cuts.gbr, VC-01 Card-F_Cu.gbr, VC-01 Card-F_Mask.gbr, VC-01 Card-F_Paste.gbr]
2020-03-13 Added local regulator for rpi core reboot persistence
    [Hat.kicad_pcb, Hat.sch]
2020-03-13 Added burden resistor jumper
    [VC-01 Card.kicad_pcb, VC-01 Card.sch]
2020-03-13 Added value silkscreen to vc card
    [VC-01 Card.kicad_pcb, VC-01 Card.sch]
2020-03-14 Added BOM to VC-01 and tidied silkscreen, added thermistor to hat. Regenerated gerbers & PDFs
    [Hat-B_Cu.gbr, Hat-B_Mask.gbr, Hat-B_Paste.gbr, Hat-B_SilkS.gbr, Hat-Edge_Cuts.gbr, Hat-F_Cu.gbr, Hat-F_Mask.gbr, Hat-F_Paste.gbr]
2020-03-14 Various BOM fixes
    [Hat.csv, Hat.kicad_pcb, Hat.ods, Hat.sch, VC-01 Card.ods]
2020-03-14 Finalised and ordered
    [Hat-B_Cu.gbr, Hat-B_Mask.gbr, Hat-B_Paste.gbr, Hat-B_SilkS.gbr, Hat-Edge_Cuts.gbr, Hat-F_Cu.gbr, Hat-F_Mask.gbr, Hat-F_Paste.gbr]
2020-03-15 Added base firmware project into vcs
    [st_nucleo_f4.cfg]
2020-04-04 GOT BLINKING LIGHTS GOING ON THE FIRST OFF PCB (no mod wires :D)
    [st_nucleo_f4.cfg]
2020-04-05 Added ADC interface (read only atm)
2020-04-05 Implemented uart receive system, working
2020-04-10 Transitioned fully to a printf alternative library, and improved the serial interface command handling
2020-04-10 Safety commit, does not work, implemented a proper card abstraction and brought in SPIFFS, modified it to allow for the card structure.
    [card.c, card.h, cardFilesystem.c, cardFilesystem.h, cardIndicator.c, cardIndicator.h, cardSpi.c, cardSpi.h]
2020-04-11 Fixed spiffs, working on hardfault issue on OS delay
    [Firmware.ioc, card.c, cardFilesystem.c, cardFilesystem.h, cardSpi.c, cardTypes.h, serialflash.c]
2020-04-11 Switched main task to static allocation and enabled freertos FPU support
2020-04-11 Added basic device config system
2020-04-11 Added card detection on all 4 slots
2020-04-12 Increased core clock up to 100MHz and increased uart clock to 460.8KHz
2020-04-18 Switched to one thread per card rtos system
    [Hat.kicad_pcb]
2020-11-01 Added LED test on boot
2020-11-01 Added version number into flash in a fixed location
    [serialInterface.c, version.h]
2020-11-01 Added proper URC printing of card data and locked timing against tick rate
