MAWoodMain/PowerMonitorMK4/(notices)

Notices in the files:
Firmware/Core/Inc/main.h:
© Copyright (c) 2020 STMicroelectronics.
All rights reserved.
This software component is licensed by ST under Ultimate Liberty license
